hsetlik/TunerVCO/Schematic/FrontPanel/BoardImg_rev1.png

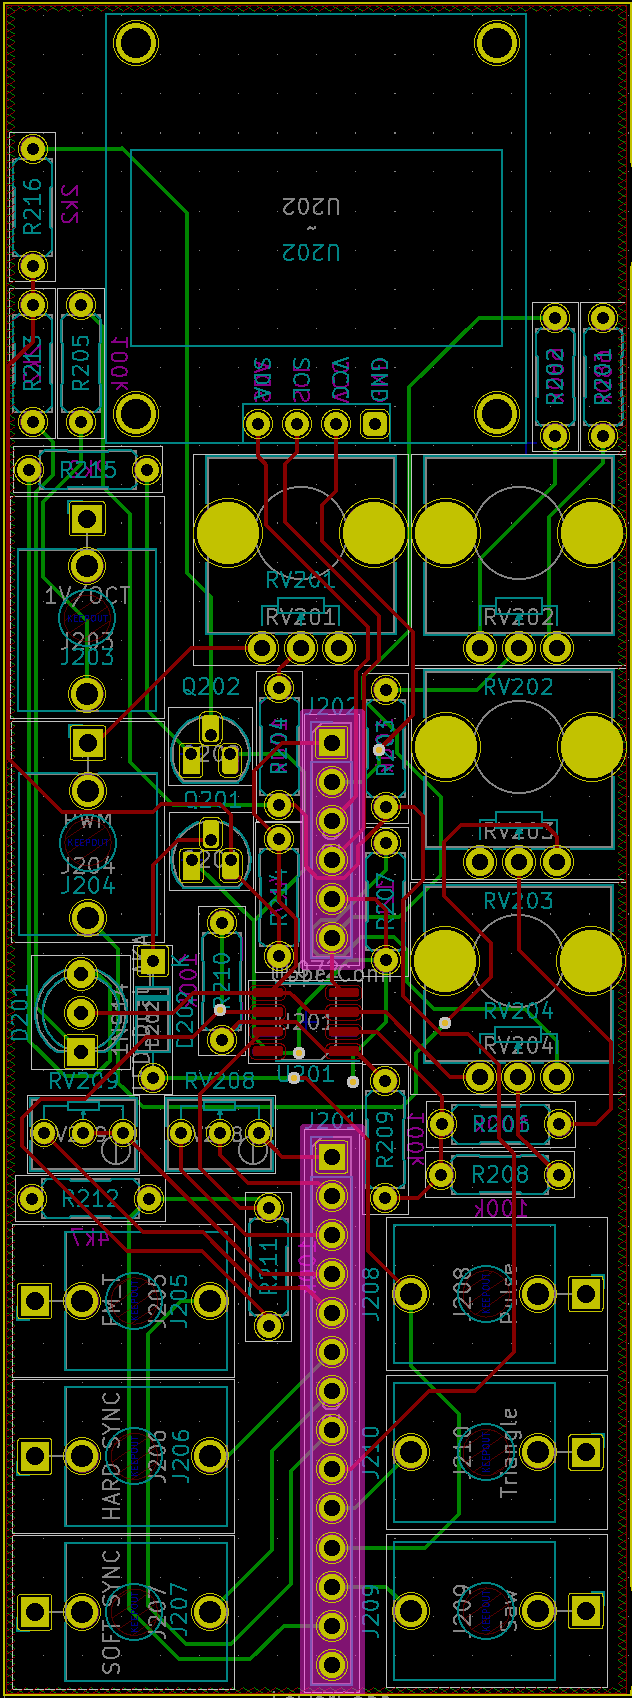
Schematic/FrontPanel/BoardImg_rev1.png
