hsetlik/TunerVCO/Schematic/PDF/TunerVCO.pdf

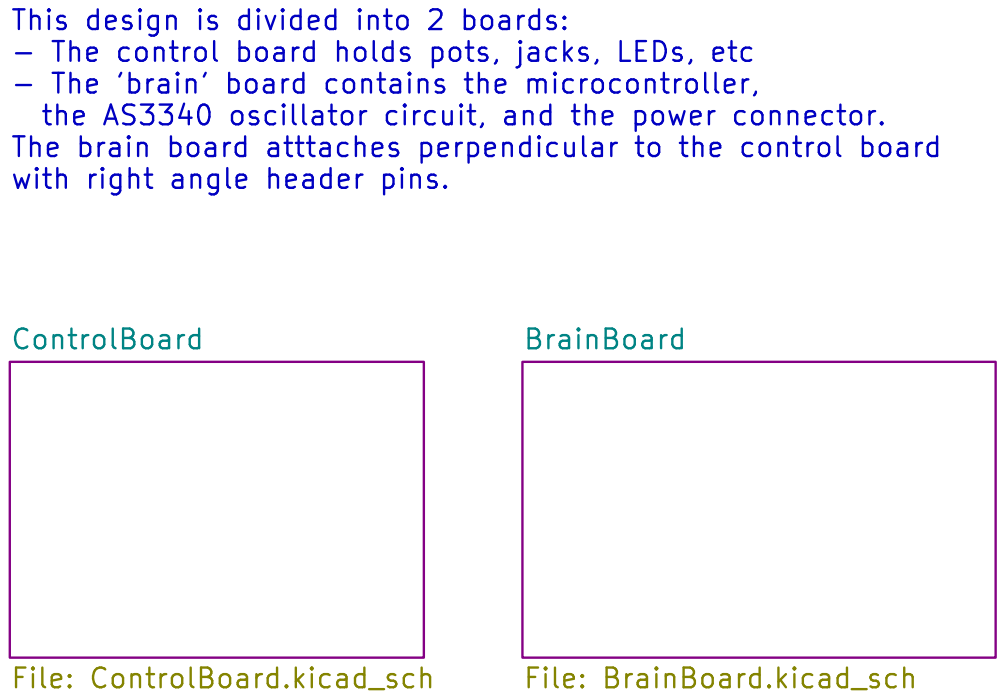
[picture p2: page 1]

File: TunerVCO.kicad_sch Sheet: / Hayden Setlik

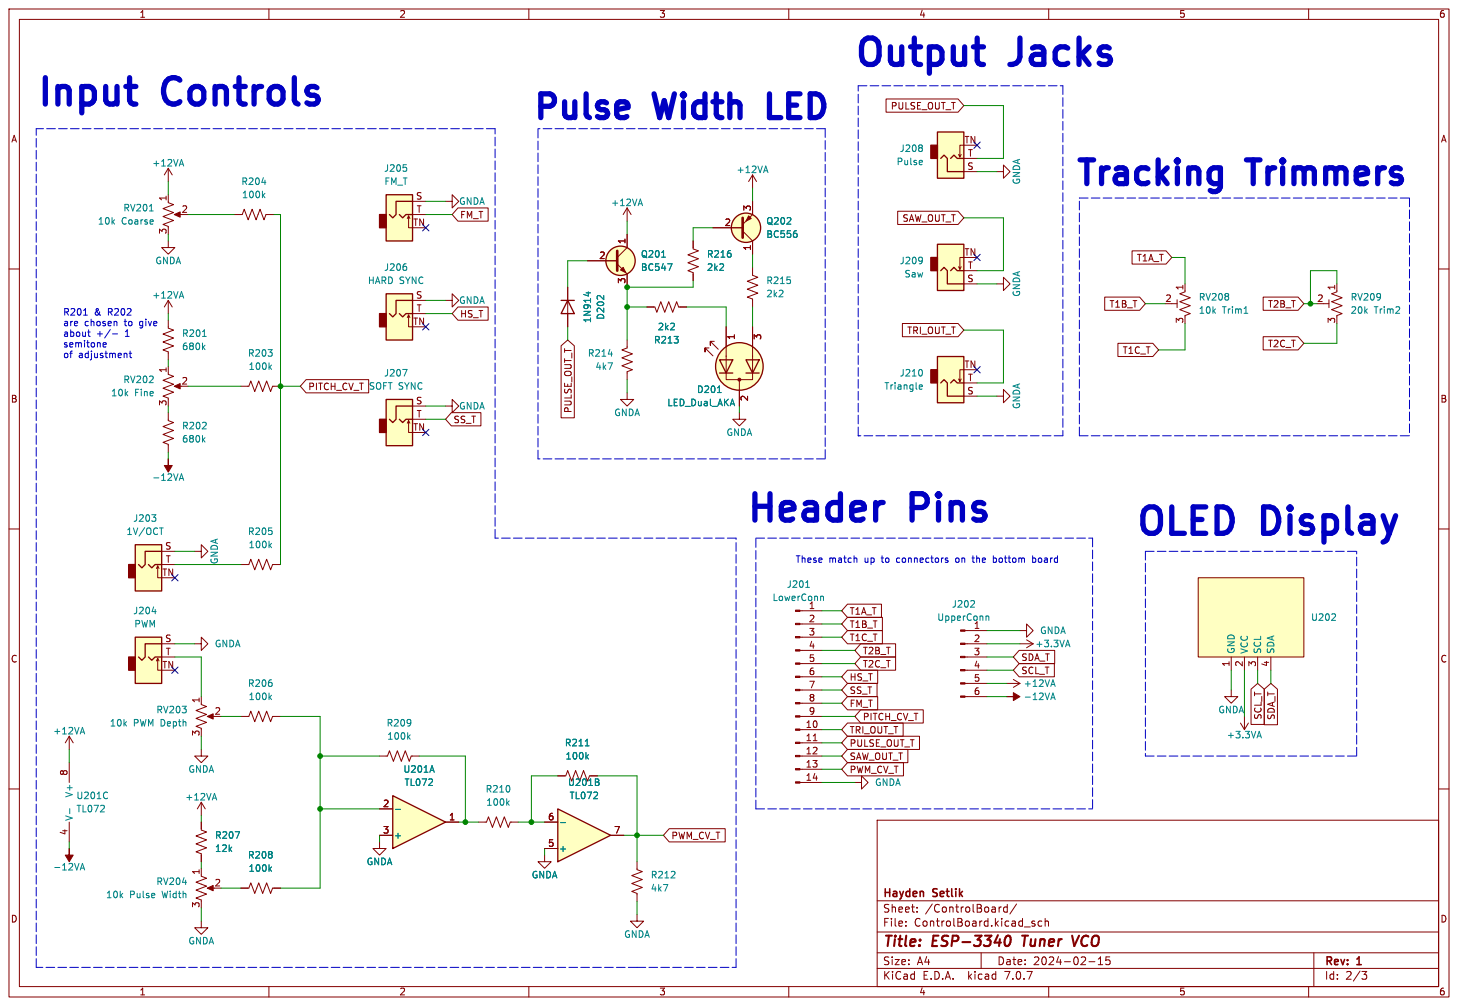
[picture p3: page 2]

are chosen to give
semitone
of adjustment

File: ControlBoard.kicad_sch Sheet: /ControlBoard/ Hayden Setlik

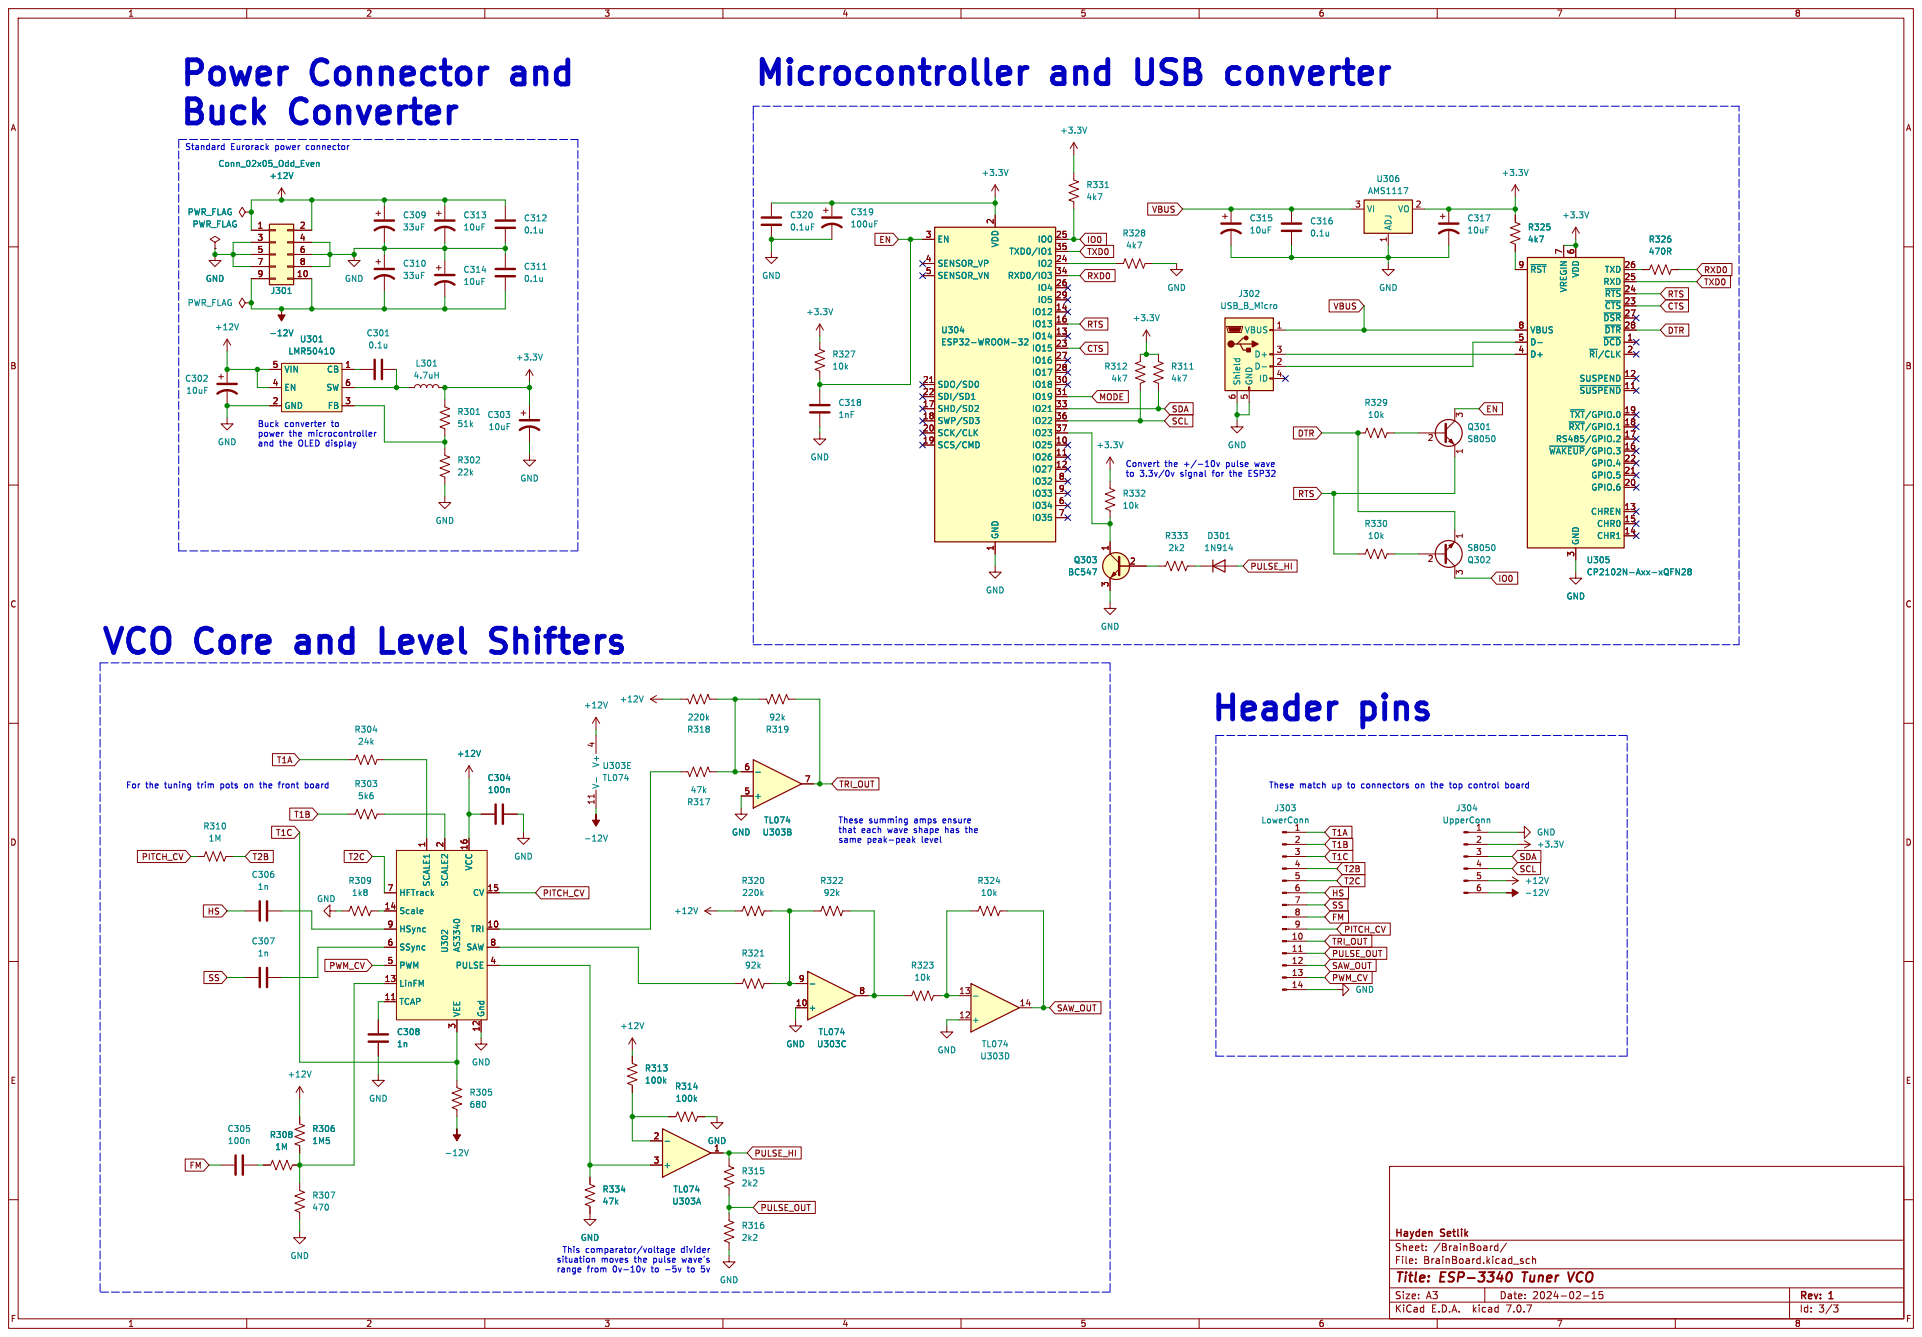
[picture p4: page 3]

2 SCK/CLK 20 SDO/SD0 21 SDI/SD1 22

power the microcontroller and the OLED display

VCO Core and Level Shifters

These summing amps ensure
that each wave shape has the

3 PULSE 4 PWM 5 SSync 6 HFTrack 7 SAW 8 HSync 9 R306
GND

3 PULSE 4 PWM 5 SSync 6 HFTrack 7 SAW 8 HSync 9 U302 AS3340
