hsetlik/TunerVCO/Schematic/TunerVCO.kicad_pcb

## KiCad design Schematic/TunerVCO.kicad_pcb (2024-02-15)

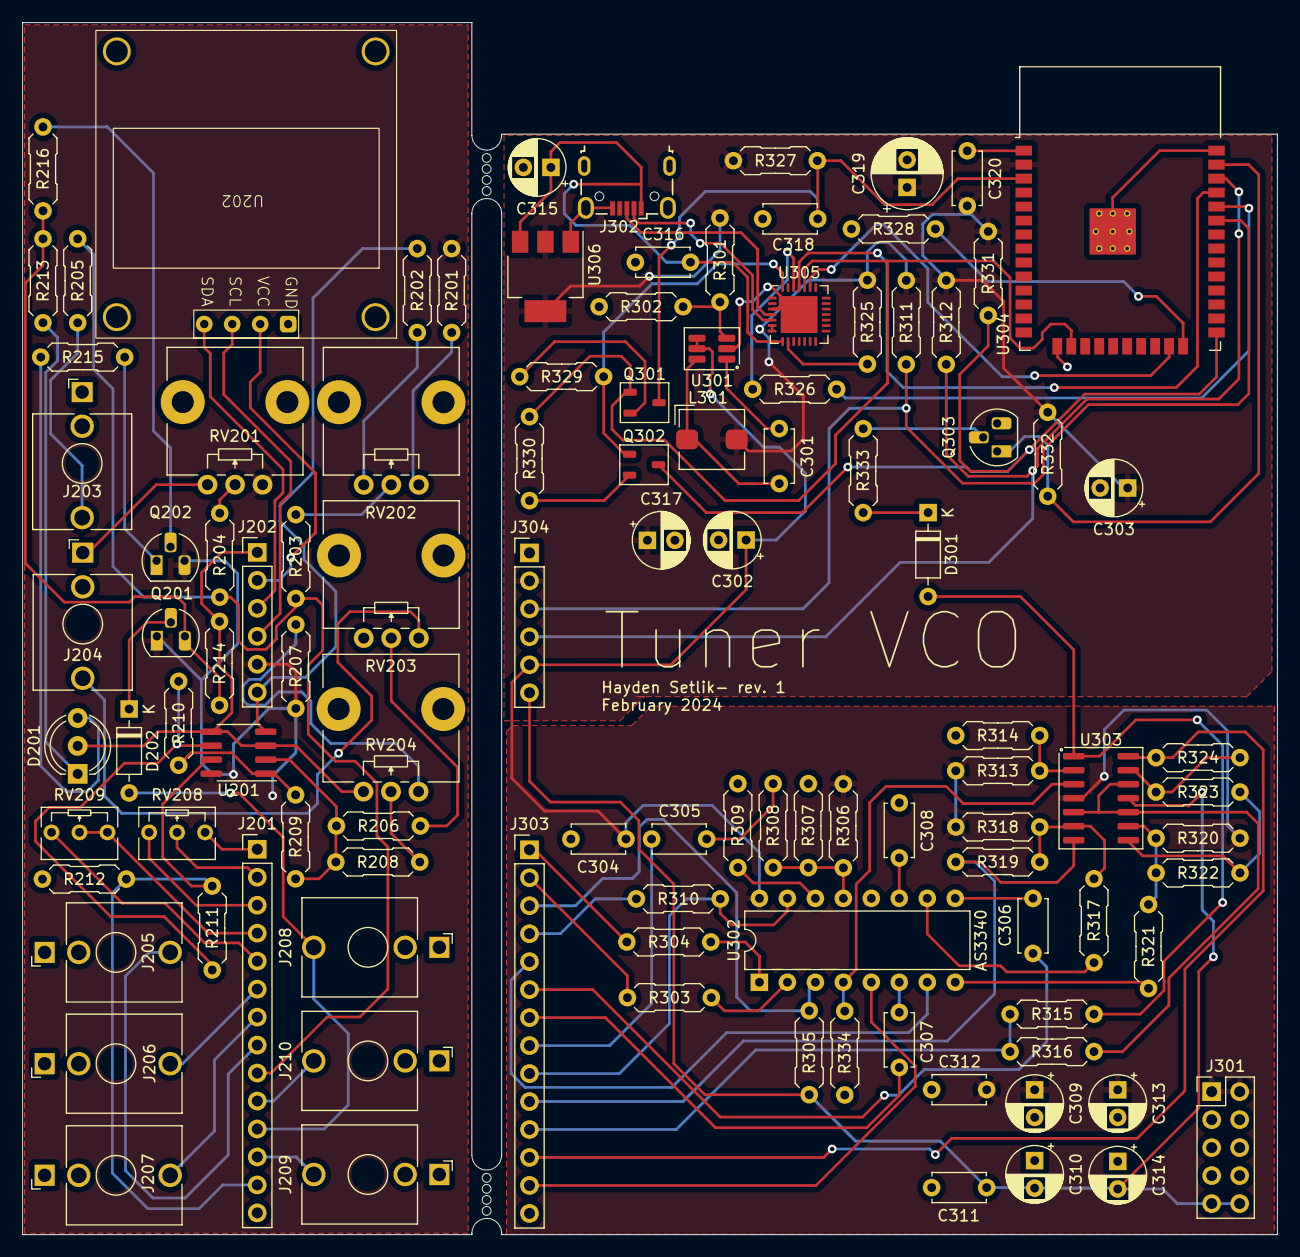
[picture p5: board TunerVCO.kicad_pcb from above]

Board: 2 copper layers, 113.9 x 110.1 mm, 107 parts (0 on the bottom side), 94 nets.

Parts:
C301, C311, C312, C316: 0.1u; C_Disc_D4.7mm_W2.5mm_P5.00mm
C302, C303, C313, C314, C315, C317: 10uF; CP_Radial_D5.0mm_P2.50mm
C304, C305: 100n; C_Disc_D4.7mm_W2.5mm_P5.00mm
C306, C307, C308: 1n; C_Disc_D4.7mm_W2.5mm_P5.00mm
C309, C310: 33uF; CP_Radial_D5.0mm_P2.50mm
C318: 1nF; C_Disc_D4.7mm_W2.5mm_P5.00mm
C319: 100uF; CP_Radial_D6.3mm_P2.50mm
C320: 0.1uF; C_Disc_D4.7mm_W2.5mm_P5.00mm
D201: LED_Dual_AKA; LED_D5.0mm-3
D202, D301: 1N914; D_DO-35_SOD27_P7.62mm_Horizontal
J201, J303: LowerConn; PinHeader_1x14_P2.54mm_Vertical
J202, J304: UpperConn; PinHeader_1x06_P2.54mm_Vertical
J203: 1V/OCT; Jack_3.5mm_QingPu_WQP-PJ398SM_Vertical_CircularHoles
J204: PWM; Jack_3.5mm_QingPu_WQP-PJ398SM_Vertical_CircularHoles
J205: FM_T; Jack_3.5mm_QingPu_WQP-PJ398SM_Vertical_CircularHoles
J206: HARD SYNC; Jack_3.5mm_QingPu_WQP-PJ398SM_Vertical_CircularHoles
J207: SOFT SYNC; Jack_3.5mm_QingPu_WQP-PJ398SM_Vertical_CircularHoles
J208: Pulse; Jack_3.5mm_QingPu_WQP-PJ398SM_Vertical_CircularHoles
J209: Saw; Jack_3.5mm_QingPu_WQP-PJ398SM_Vertical_CircularHoles
J210: Triangle; Jack_3.5mm_QingPu_WQP-PJ398SM_Vertical_CircularHoles
J301: Conn_02x05_Odd_Even; PinHeader_2x05_P2.54mm_Vertical
J302: USB_B_Micro; USB_Micro-B_Wuerth_629105150521
L301: 4.7uH; L_Bourns_SRP5030T
Q201, Q303: BC547; TO-92_HandSolder
Q202: BC556; TO-92_HandSolder
Q301, Q302: S8050; TSOT-23
R201, R202: 680k; R_Axial_DIN0207_L6.3mm_D2.5mm_P7.62mm_Horizontal
R203, R204, R205, R206, R208, R209, R210, R211, R313, R314: 100k; R_Axial_DIN0207_L6.3mm_D2.5mm_P7.62mm_Horizontal
R207: 12k; R_Axial_DIN0207_L6.3mm_D2.5mm_P7.62mm_Horizontal
R212, R214, R311, R312, R325, R328, R331: 4k7; R_Axial_DIN0207_L6.3mm_D2.5mm_P7.62mm_Horizontal
R213, R215, R216, R315, R316, R333: 2k2; R_Axial_DIN0207_L6.3mm_D2.5mm_P7.62mm_Horizontal
R301: 51k; R_Axial_DIN0207_L6.3mm_D2.5mm_P7.62mm_Horizontal
R302: 22k; R_Axial_DIN0207_L6.3mm_D2.5mm_P7.62mm_Horizontal
R303: 5k6; R_Axial_DIN0207_L6.3mm_D2.5mm_P7.62mm_Horizontal
R304: 24k; R_Axial_DIN0207_L6.3mm_D2.5mm_P7.62mm_Horizontal
R305: 680; R_Axial_DIN0207_L6.3mm_D2.5mm_P7.62mm_Horizontal
R306: 1M5; R_Axial_DIN0207_L6.3mm_D2.5mm_P7.62mm_Horizontal
R307: 470; R_Axial_DIN0207_L6.3mm_D2.5mm_P7.62mm_Horizontal
R308, R310: 1M; R_Axial_DIN0207_L6.3mm_D2.5mm_P7.62mm_Horizontal
R309: 1k8; R_Axial_DIN0207_L6.3mm_D2.5mm_P7.62mm_Horizontal
R317, R334: 47k; R_Axial_DIN0207_L6.3mm_D2.5mm_P7.62mm_Horizontal
R318, R320: 220k; R_Axial_DIN0207_L6.3mm_D2.5mm_P7.62mm_Horizontal
R319, R321, R322: 92k; R_Axial_DIN0207_L6.3mm_D2.5mm_P7.62mm_Horizontal
R323, R324, R327, R329, R330, R332: 10k; R_Axial_DIN0207_L6.3mm_D2.5mm_P7.62mm_Horizontal
R326: 470R; R_Axial_DIN0207_L6.3mm_D2.5mm_P7.62mm_Horizontal
RV201: 10k Coarse; Potentiometer_Alps_RK09L_Single_Vertical
RV202: 10k Fine; Potentiometer_Alps_RK09L_Single_Vertical
RV203: 10k PWM Depth; Potentiometer_Alps_RK09L_Single_Vertical
RV204: 10k Pulse Width; Potentiometer_Alps_RK09L_Single_Vertical
RV208: 10k Trim1; Potentiometer_Bourns_3266Y_Vertical
RV209: 20k Trim2; Potentiometer_Bourns_3266Y_Vertical
U201: TL072; SOIC-8_3.9x4.9mm_P1.27mm
U202: SSD1306_OLED_128x64
U301: LMR50410; SOT-23-6_BigPads
U302: AS3340; DIP-16_W7.62mm
U303: TL074; SOIC-14_3.9x8.7mm_P1.27mm
U304: ESP32-WROOM-32
U305: CP2102N-Axx-xQFN28; QFN-28-1EP_5x5mm_P0.5mm_EP3.35x3.35mm
U306: AMS1117; SOT-223-3_TabPin2

Connections:
+3.3V: C303.1, C317.1, C319.1, C320.2, J304.2, L301.2, R301.1, R311.2, R312.2, R325.1, R327.1, R331.2, R332.2, U304.2 (VDD), U305.6 (VDD), U305.7 (VREGIN), U306.2 (VO)
+3.3VA: J202.2, U202.2 (VCC)
+12V: C302.1, C304.1, C309.1, C312.2, C313.1, J301.1, J301.2, J304.5, R306.2, R313.1, R318.1, R320.1, U301.4 (EN), U301.5 (VIN), U302.16 (VCC), U303.4 (V+)
+12VA: J202.5, Q201.1 (C), Q202.3 (E), R201.1, R207.2, RV201.1, U201.8 (V+)
-12V: C310.2, C311.1, C314.2, J301.9, J301.10, J304.6, R305.1, U303.11 (V-)
-12VA: J202.6, R202.2, U201.4 (V-)
CTS: U304.23 (IO15), U305.23 (~CTS)
DTR: Q302.1 (E), R329.1, U305.28 (~DTR)
EN: C318.2, Q301.3 (C), R327.2, U304.3 (EN)
FM: C305.1, J303.8
FM_T: J201.8, J205.T
GND: C302.2, C303.2, C304.2, C308.1, C309.2, C310.1, C311.2, C312.1, C313.2, C314.1, C315.2, C316.1, C317.2, C318.1, C319.2, C320.1, J301.3, J301.4, J301.5, J301.6, J301.7, J301.8, J302.5 (GND), J302.6 (Shield), J303.14, J304.1, Q303.3 (E), R302.2, R307.1, R309.1, R314.2, R316.2, R328.2, R334.2, U301.2 (GND), U302.12 (Gnd), U303.5 (+), U303.10 (+), U303.12 (+), U304.1 (GND), U304.15 (GND), U304.38 (GND), U304.39 (GND), U305.3 (GND), U305.29 (GND), U306.1 (ADJ)
GNDA: D201.2 (K), J201.14, J202.1, J203.S, J204.S, J205.S, J206.S, J207.S, J208.S, J209.S, J210.S, R212.1, R214.2, RV201.3, RV203.3, RV204.3, U201.3 (+), U201.5 (+), U202.1 (GND)
HS: C306.1, J303.6
HS_T: J201.6, J206.T
IO0: Q302.3 (C), R331.1, U304.25 (IO0)
unnamed: C305.2, R308.2
unnamed: D201.1 (A1), R213.2
unnamed: D201.3 (A2), R215.2
unnamed: D202.1 (K), Q201.2 (B)
unnamed: D301.1 (K), R333.1
unnamed: J203.T, R205.1
unnamed: J204.T, RV203.1
unnamed: J302.3 (D+), U305.4 (D+)
unnamed: J302.2 (D-), U305.5 (D-)
unnamed: Q201.3 (E), R213.1, R214.1, R216.2
unnamed: Q202.2 (B), R216.1
unnamed: Q202.1 (C), R215.1
unnamed: Q301.2 (B), R329.2
unnamed: Q302.2 (B), R330.2
unnamed: Q303.2 (B), R333.2
unnamed: Q303.1 (C), R332.1, U304.37 (IO23)
unnamed: R201.2, RV202.1
unnamed: R202.1, RV202.3
unnamed: R203.1, RV202.2
unnamed: R204.1, RV201.2
unnamed: R206.1, RV203.2
unnamed: R207.1, RV204.1
unnamed: R208.1, RV204.2
unnamed: R209.2, R210.1, U201.1
unnamed: R322.2, R323.1, U303.8
unnamed: R206.2, R208.2, R209.1, U201.2 (-)
unnamed: R210.2, R211.1, U201.6 (-)
unnamed: C301.1, U301.1 (CB)
unnamed: R301.2, R302.1, U301.3 (FB)
unnamed: C301.2, L301.1, U301.6 (SW)
unnamed: C306.2, U302.9 (HSync)
unnamed: R306.1, R307.2, R308.1, U302.13 (LinFM)
unnamed: R334.1, U302.4 (PULSE), U303.3 (+)
unnamed: R321.1, U302.8 (SAW)
unnamed: R304.2, U302.1 (SCALE1)
unnamed: R303.2, U302.2 (SCALE2)
unnamed: C307.2, U302.6 (SSync)
unnamed: R309.2, U302.14 (Scale)
unnamed: C308.2, U302.11 (TCAP)
unnamed: R317.1, U302.10 (TRI)
unnamed: R313.2, R314.1, U303.2 (-)
unnamed: R317.2, R318.2, R319.1, U303.6 (-)
unnamed: R320.2, R321.2, R322.1, U303.9 (-)
unnamed: R323.2, R324.1, U303.13 (-)
unnamed: R328.1, U304.24 (IO2)
unnamed: R326.1, U305.26 (TXD)
unnamed: R325.2, U305.9 (~RST)
PITCH_CV: J303.9, R310.1, U302.15 (CV)
PITCH_CV_T: J201.9, R203.2, R204.2, R205.2
PULSE_HI: D301.2 (A), R315.1, U303.1
PULSE_OUT: J303.11, R315.2, R316.1
PULSE_OUT_T: D202.2 (A), J201.11, J208.T
PWM_CV: J303.13, U302.5 (PWM)
PWM_CV_T: J201.13, R211.2, R212.2, U201.7
RTS: Q301.1 (E), R330.1, U304.16 (IO13), U305.24 (~RTS)
RXD0: R326.2, U304.34 (RXD0/IO3)
SAW_OUT: J303.12, R324.2, U303.14
SAW_OUT_T: J201.12, J209.T
SCL: J304.4, R312.1, U304.36 (IO22)
SCL_T: J202.4, U202.3 (SCL)
SDA: J304.3, R311.1, U304.33 (IO21)
SDA_T: J202.3, U202.4 (SDA)
SS: C307.1, J303.7
SS_T: J201.7, J207.T
T1A: J303.1, R304.1
T1A_T: J201.1, RV208.1
T1B: J303.2, R303.1
T1B_T: J201.2, RV208.2
T1C: J303.3, R305.2, U302.3 (VEE)
T1C_T: J201.3, RV208.3
T2B: J303.4, R310.2
T2B_T: J201.4, RV209.1, RV209.2
T2C: J303.5, U302.7 (HFTrack)
T2C_T: J201.5, RV209.3
TRI_OUT: J303.10, R319.2, U303.7
TRI_OUT_T: J201.10, J210.T
TXD0: U304.35 (TXD0/IO1), U305.25 (RXD)
VBUS: C315.1, C316.2, J302.1 (VBUS), U305.8 (VBUS), U306.3 (VI)
