hsetlik/TunerVCO/(commit log)

2024-02-15 added KiCad stuff to git
    [BrainBoard.kicad_sch, ControlBoard.kicad_sch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]
2024-02-15 schematic PDF
